Alex-herzong/bb8-3d-printing/bb8教程附件（非拓展板）/问题请扫二维码加我.jpg

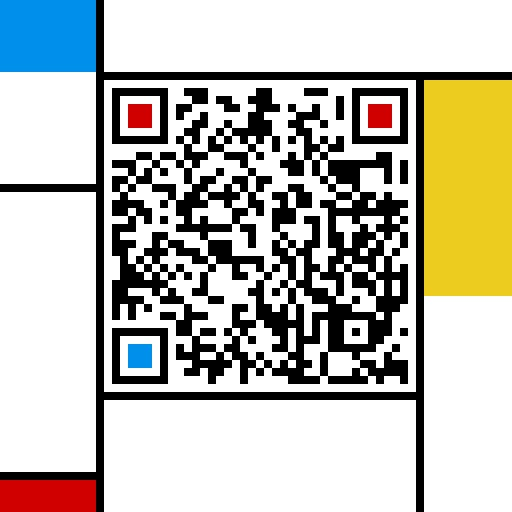
bb8教程附件（非拓展板）/问题请扫二维码加我.jpg
