Alex-herzong/bb8-3d-printing/bb8教程附件（非拓展板）/bb-8机器人制作配件清单.docx

名称 | 链接
250mm、5mm透明亚克力球各一个 | https://detail.tmall.com/item.htm?id=527342035429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 (https://detail.tmall.com/item.htm?id=527342035429&ad_id=&am_id=&cm_id=140105335569ed55e27b&pm_id=&abbucket=16) https://item.taobao.com/item.htm?spm=a1z0d.6639537.1997196601.16.N8McYl&id=41409008235
黄色、银色、黑色、白色喷漆各一瓶 | https://detail.tmall.com/item.htm?id=40748334225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
美纹纸一卷、收音机天线两个 | https://item.taobao.com/item.htm?spm=a230r.1.14.23.nArhsa&id=37469330110&ns=1&abbucket=16#detail
迷你塑料万向球6个、金属万向球2个 | https://item.taobao.com/item.htm?id=41189327831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 https://item.taobao.com/item.htm?spm=a230r.1.14.47.n4MZAc&id=37784466479&ns=1&abbucket=16#detail
20*10圆形强磁2个、20*5圆形强磁2个 | https://shop73172975.taobao.com/category-1174170889.htm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
M3螺栓螺母若干
普通小车马达加轮子2个 | https://detail.tmall.com/item.htm?id=42875687265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
蓝牙模块1个 | https://item.taobao.com/item.htm?spm=a1z09.2.0.0.IatADj&id=520697268815&_u=5did47a13e1
Arduino单片机1个 | https://item.taobao.com/item.htm?spm=a1z09.2.0.0.IatADj&id=44948626552&_u=5did47a69f5
12v锂电池（包括充电器） | https://item.taobao.com/item.htm?spm=a1z09.2.0.0.IatADj&id=524996959929&_u=5did47ab021
稳压模块5v1个 | https://item.taobao.com/item.htm?spm=a1z09.2.0.0.IatADj&id=37939593298&_u=5did47a3a1b
L298n电机驱动1个 | https://detail.tmall.com/item.htm?id=18566053714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 (https://detail.tmall.com/item.htm?id=18566053714&cm_id=140105335569ed55e27b&abbucket=16)
自锁开关1个 | https://item.taobao.com/item.htm?spm=a1z09.2.0.0.IatADj&id=520850580871&_u=5did47a573d
RDS3115舵机1个 | https://item.taobao.com/item.htm?spm=a230r.1.14.4.23b55e6e2gYSWj&id=521728033704&ns=1&abbucket=12#detail
配种物料(自行处理) | 两根直径为25到30mm，长度为100mm的圆柱实心钢材
杜邦线若干 | https://detail.tmall.com/item.htm?id=21555044507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 针孔，针针，孔孔都买些
砂纸若干 | 自己找
打印件 联系微信1451520838打印 | 包括头部、底板、顶部支撑
塑料扎带 | 长扎带若干
透明胶 | 用于粘紧外壳

工具 | 剪刀，刻刀，十字螺丝刀，钳子，热熔胶枪，油性笔，铅笔，圆规等比用工具
