Alex-herzong/bb8-3d-printing/bb8教程附件（非拓展板）/bb-8sw模型/自动恢复 BB-8.SLDASM

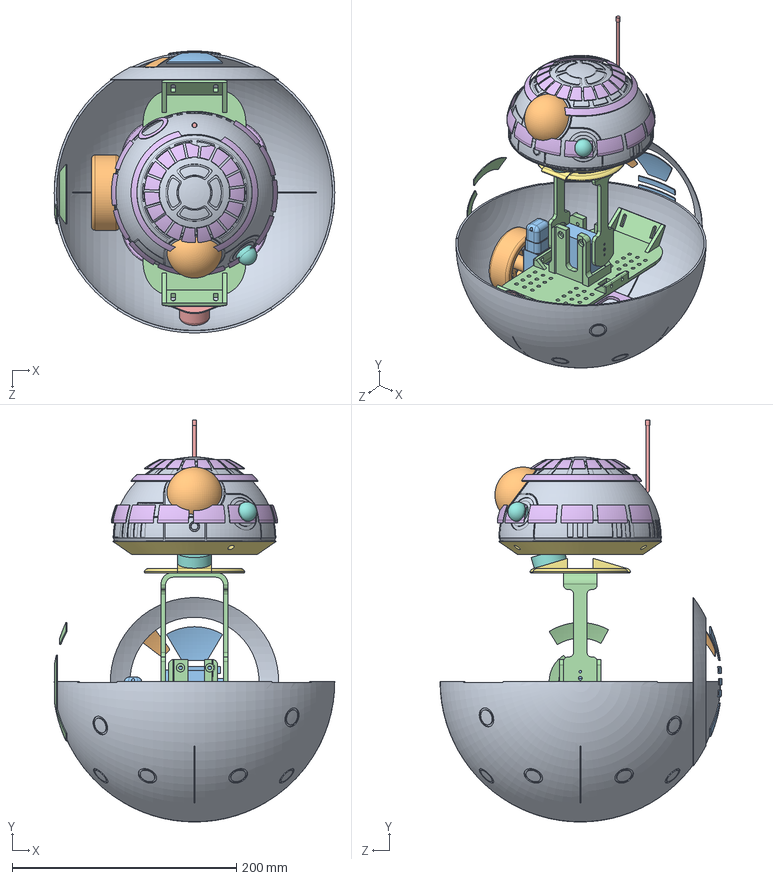
[picture p42: CAD file, 2020-06-07]
bb8教程附件（非拓展板）/bb-8sw模型/自动恢复 BB-8.SLDASM
250.0 x 358.2 x 251.2 mm
底板1
底板2
支撑盘
头部转盘
datou
SR403P舵机
摇臂
