Alex-herzong/bb8-3d-printing/bb8教程附件（非拓展板）/bb-8sw模型/BB-8.SLDASM

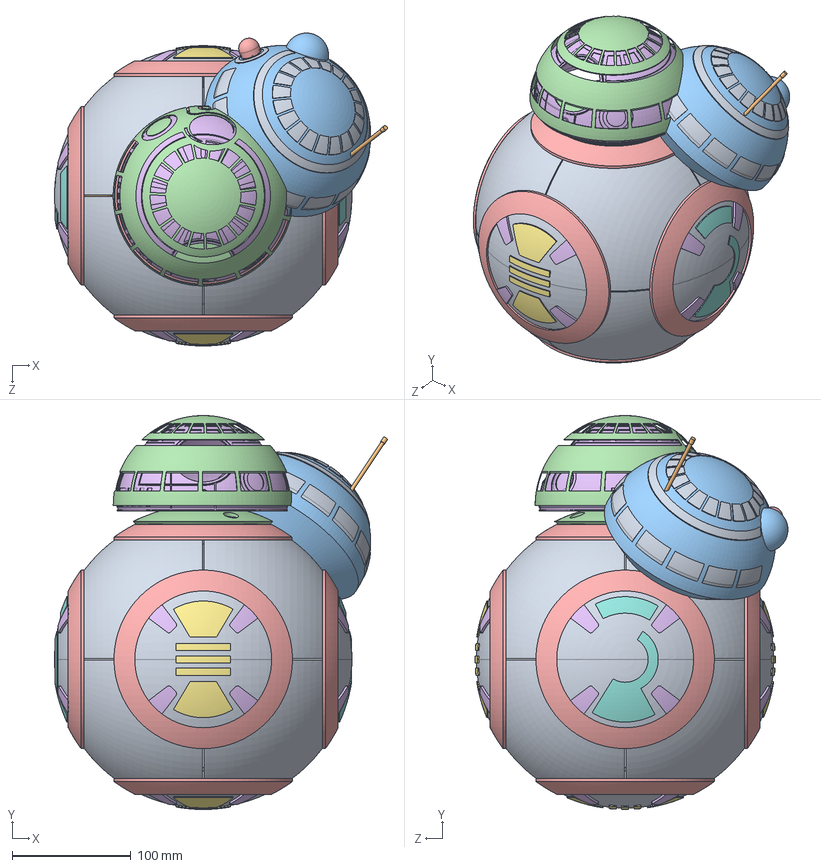
[picture p43: CAD file, 2020-06-07]
bb8教程附件（非拓展板）/bb-8sw模型/BB-8.SLDASM
279.9 x 331.1 x 263.0 mm
外壳1 x 2
车轮 x 2
减速电机2 x 2
零件2
辉盛995舵机
角球 x 2
零件4
舵盘
脖子
支撑盘
磁铁 x 2
waike1^BB-8 x 6
waike2 x 24
waike3 x 4
waike4 x 2
toubudayin
