Alex-herzong/bb8-3d-printing/bb8教程附件（非拓展板）/bb-8sw模型/waike6.sldprt

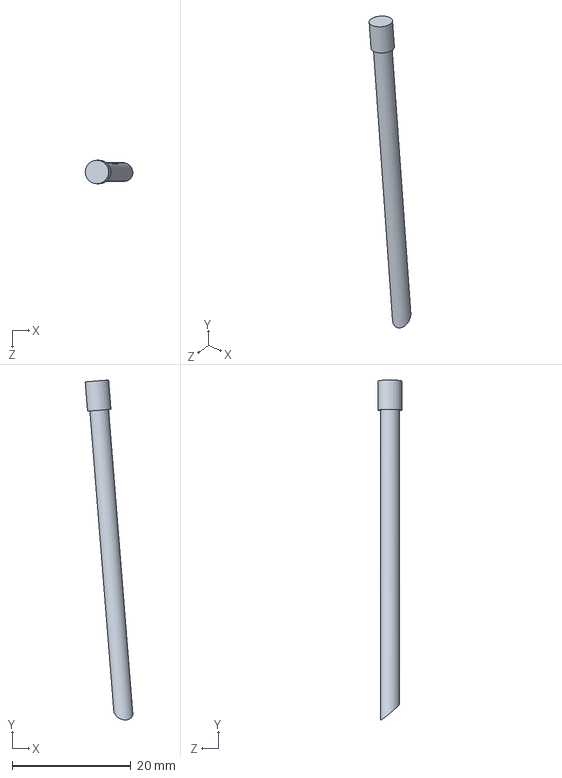
[picture p44: CAD file, 2020-06-07]
bb8教程附件（非拓展板）/bb-8sw模型/waike6.sldprt
8.04 x 57.3 x 3.97 mm
