Alex-herzong/bb8-3d-printing/bb8教程附件（非拓展板）/bb-8sw模型/底板2.sldprt

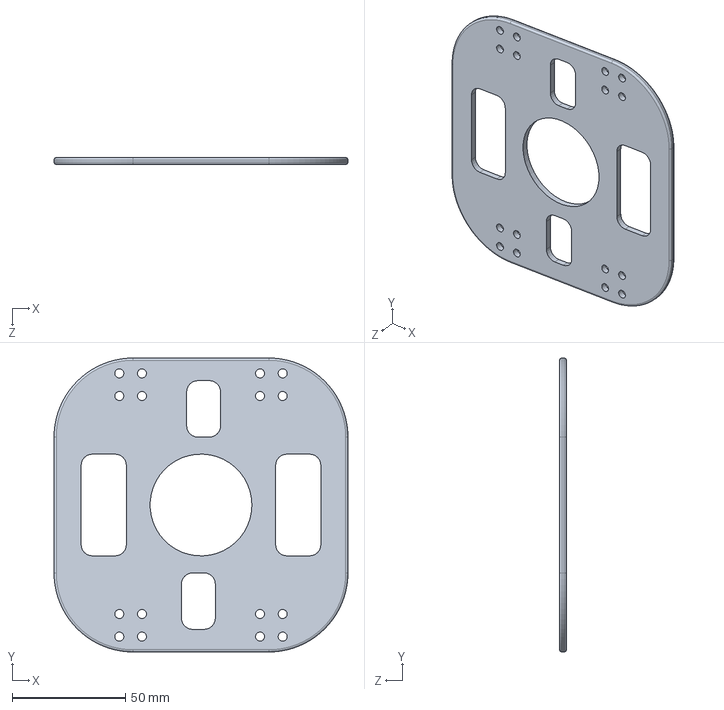
[picture p45: CAD file, 2020-06-07]
bb8教程附件（非拓展板）/bb-8sw模型/底板2.sldprt
130.0 x 130.0 x 3.00 mm
