Alex-herzong/bb8-3d-printing/bb8教程附件（非拓展板）/bb-8sw模型/底板1.sldprt

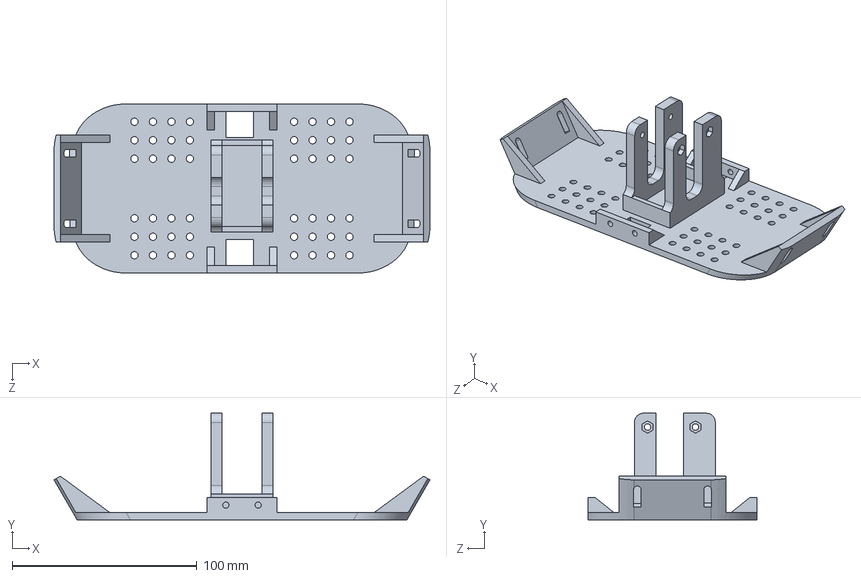
[picture p46: CAD file, 2020-06-07]
bb8教程附件（非拓展板）/bb-8sw模型/底板1.sldprt
203.5 x 57.8 x 91.5 mm
