Alex-herzong/bb8-3d-printing/bb8教程附件（非拓展板）/bb-8sw模型/角球.SLDPRT

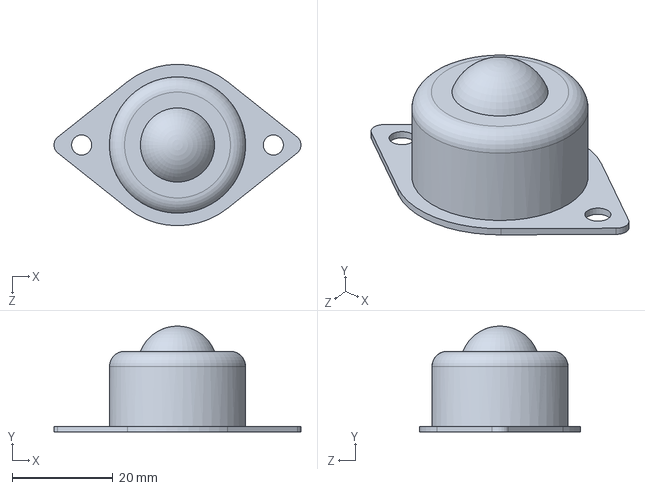
[picture p47: CAD file, 2020-06-07]
bb8教程附件（非拓展板）/bb-8sw模型/角球.SLDPRT
49.0 x 21.0 x 32.0 mm
