Alex-herzong/bb8-3d-printing/bb8教程附件（非拓展板）/bb-8sw模型/头部.sldprt

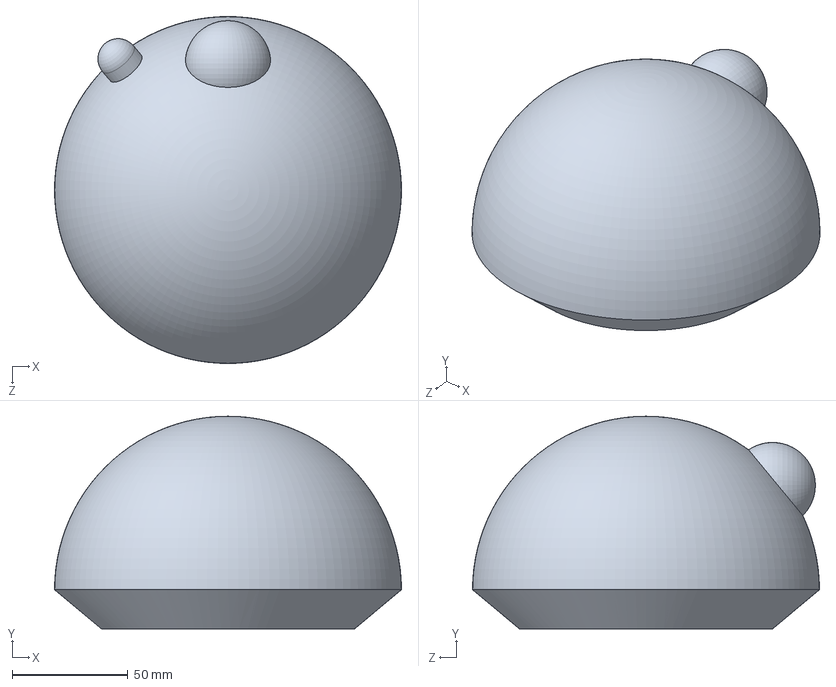
[picture p48: CAD file, 2020-06-07]
bb8教程附件（非拓展板）/bb-8sw模型/头部.sldprt
150.0 x 91.9 x 150.0 mm
