Alex-herzong/bb8-3d-printing/bb8教程附件（非拓展板）/bb-8sw模型/车轮.SLDPRT

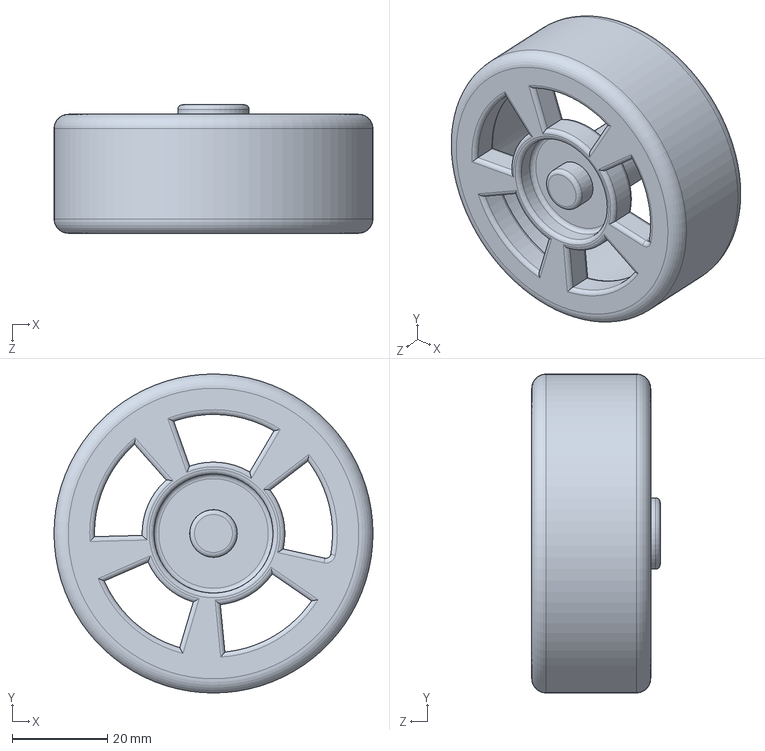
[picture p49: CAD file, 2020-06-07]
bb8教程附件（非拓展板）/bb-8sw模型/车轮.SLDPRT
67.0 x 67.0 x 27.0 mm
