Alex-herzong/bb8-3d-printing/bb8教程附件（非拓展板）/bb-8sw模型/支撑盘.sldprt

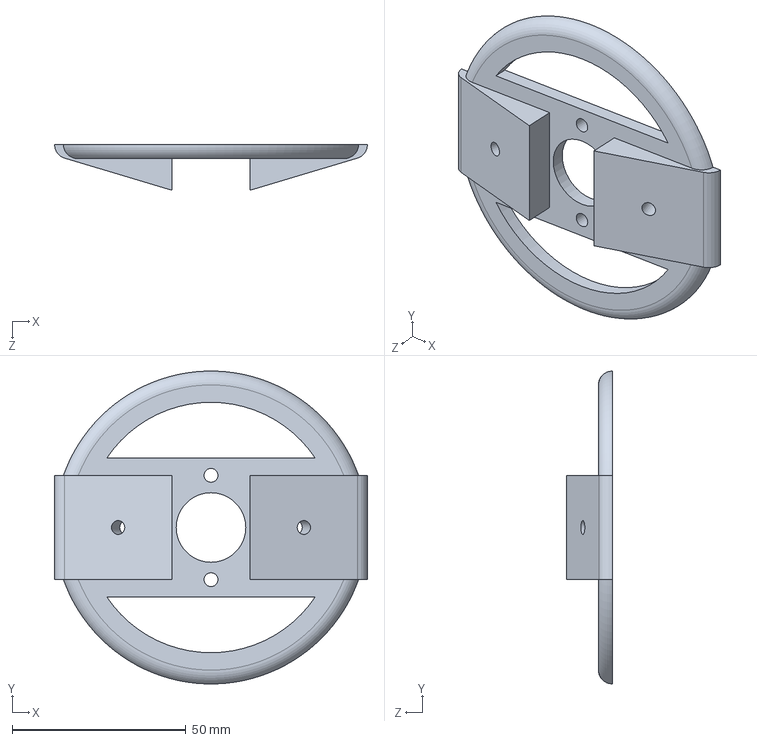
[picture p50: CAD file, 2020-06-07]
bb8教程附件（非拓展板）/bb-8sw模型/支撑盘.sldprt
90.0 x 90.0 x 13.1 mm
