Alex-herzong/bb8-3d-printing/bb8教程附件（非拓展板）/bb-8sw模型/waike1.sldprt

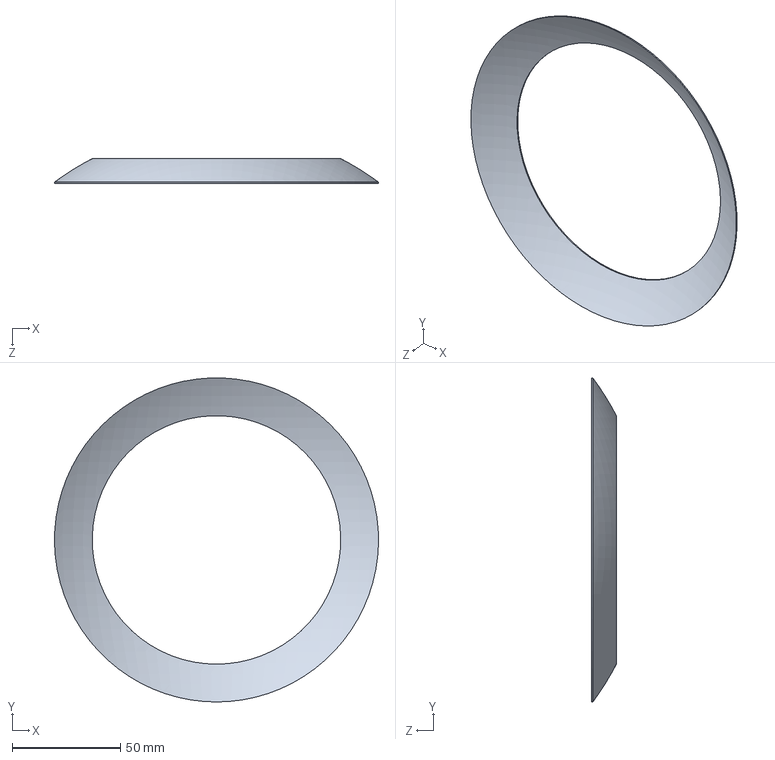
[picture p51: CAD file, 2020-06-07]
bb8教程附件（非拓展板）/bb-8sw模型/waike1.sldprt
150.0 x 149.9 x 11.5 mm
