Alex-herzong/bb8-3d-printing/bb8教程附件（非拓展板）/bb-8sw模型/waike2.sldprt

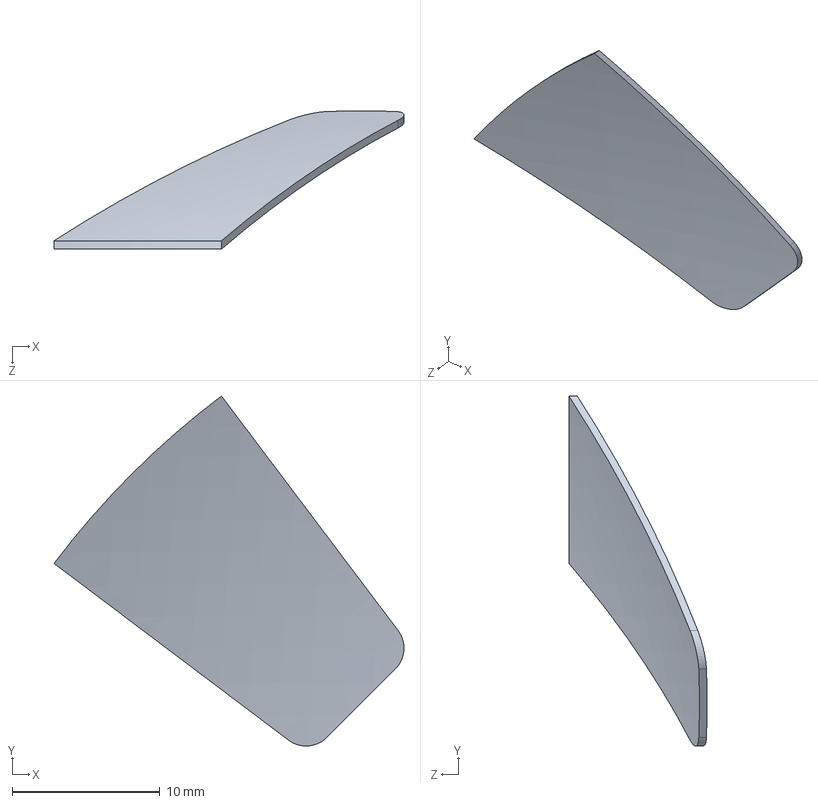
[picture p52: CAD file, 2020-06-07]
bb8教程附件（非拓展板）/bb-8sw模型/waike2.sldprt
23.7 x 23.7 x 9.34 mm
