Alex-herzong/bb8-3d-printing/bb8教程附件（非拓展板）/bb-8sw模型/减速电机2.SLDPRT

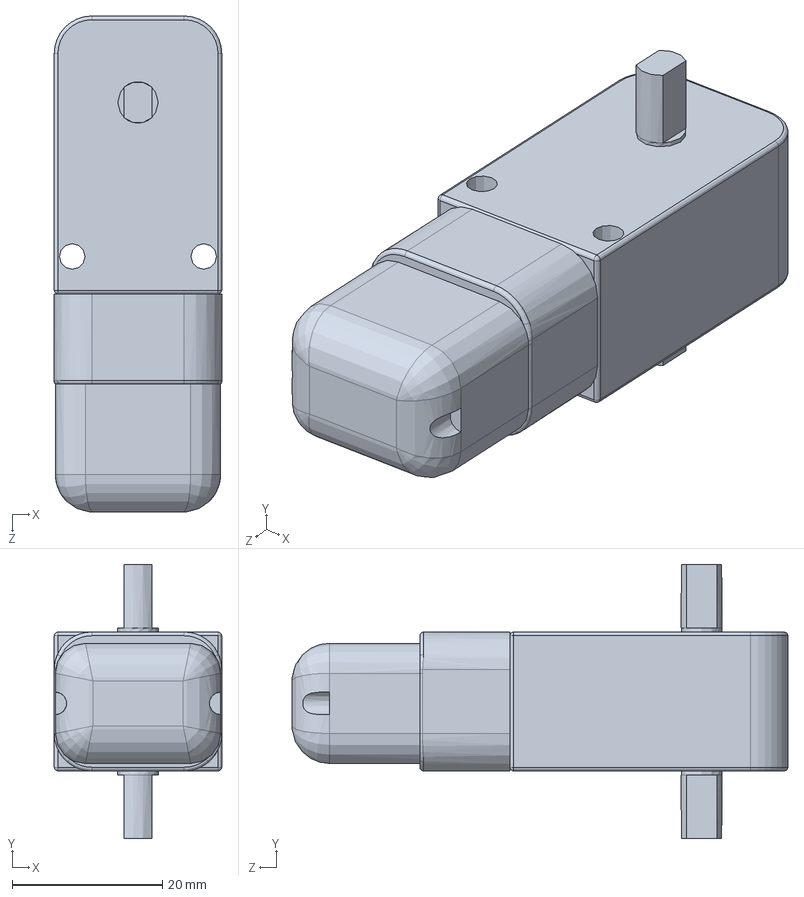
[picture p53: CAD file, 2020-06-07]
bb8教程附件（非拓展板）/bb-8sw模型/减速电机2.SLDPRT
22.3 x 36.5 x 66.0 mm
