Alex-herzong/bb8-3d-printing/bb8教程附件（非拓展板）/bb-8sw模型/磁铁.SLDPRT

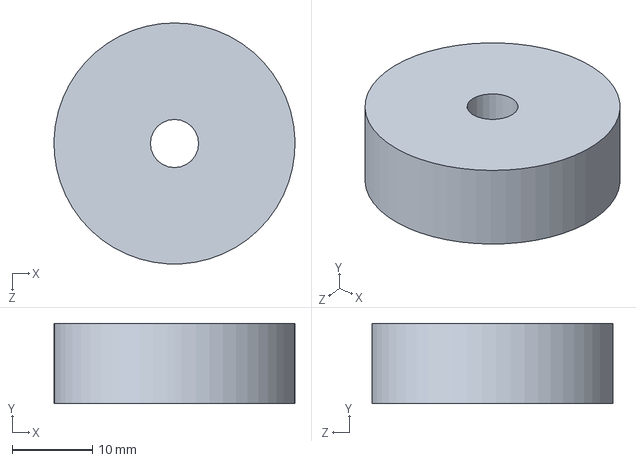
[picture p54: CAD file, 2020-06-07]
bb8教程附件（非拓展板）/bb-8sw模型/磁铁.SLDPRT
30.0 x 10.0 x 30.0 mm
