Alex-herzong/bb8-3d-printing/bb8教程附件（非拓展板）/bb-8sw模型/摇臂.sldprt

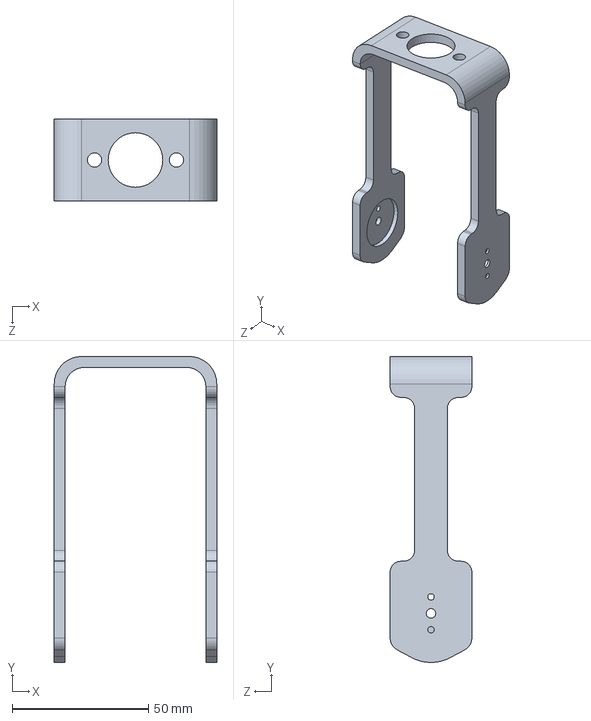
[picture p55: CAD file, 2020-06-07]
bb8教程附件（非拓展板）/bb-8sw模型/摇臂.sldprt
59.5 x 112.1 x 30.0 mm
