Alex-herzong/bb8-3d-printing/bb8教程附件（非拓展板）/bb-8sw模型/SR403P舵机.SLDPRT

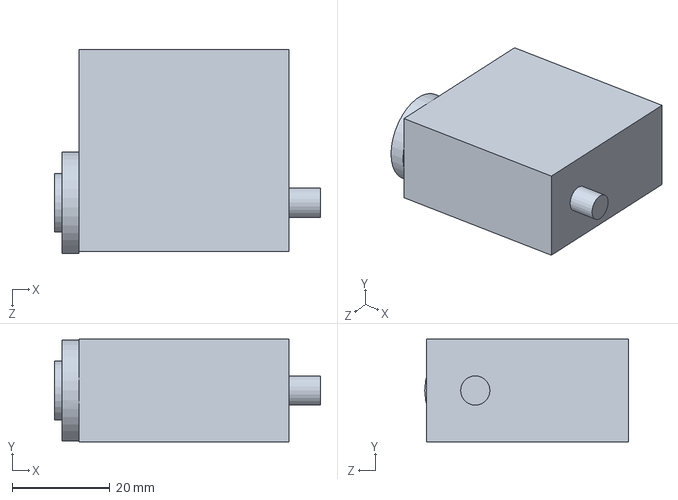
[picture p56: CAD file, 2020-06-07]
bb8教程附件（非拓展板）/bb-8sw模型/SR403P舵机.SLDPRT
54.4 x 21.0 x 41.7 mm
