Alex-herzong/bb8-3d-printing/bb8教程附件（非拓展板）/bb-8sw模型/眼睛.SLDPRT

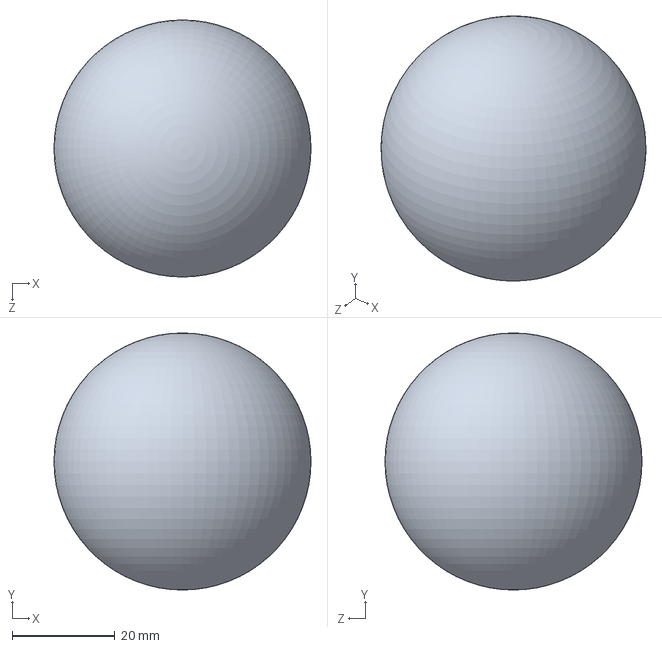
[picture p57: CAD file, 2020-06-07]
bb8教程附件（非拓展板）/bb-8sw模型/眼睛.SLDPRT
50.0 x 50.0 x 50.0 mm
