Alex-herzong/bb8-3d-printing/bb8教程附件（非拓展板）/bb-8sw模型/14.5cm新转盘.sldprt

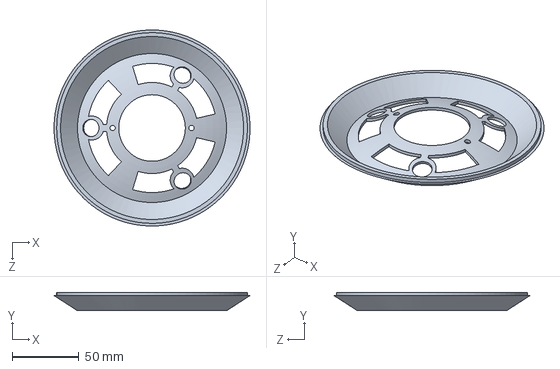
[picture p58: CAD file, 2020-06-07]
bb8教程附件（非拓展板）/bb-8sw模型/14.5cm新转盘.sldprt
147.3 x 13.9 x 147.4 mm
