Alex-herzong/bb8-3d-printing/bb8教程附件（非拓展板）/bb-8sw模型/外壳1.sldprt

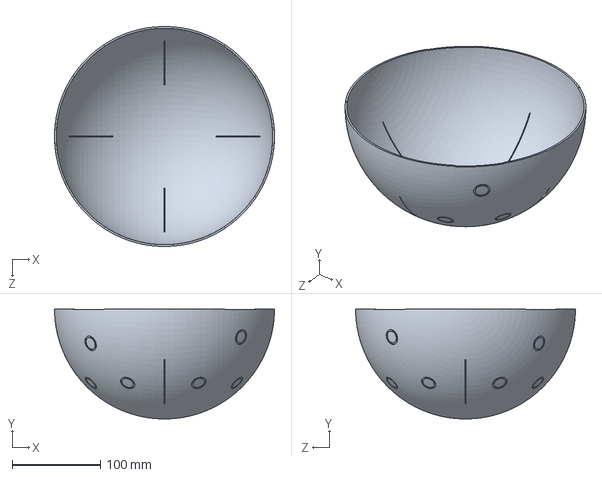
[picture p59: CAD file, 2020-06-07]
bb8教程附件（非拓展板）/bb-8sw模型/外壳1.sldprt
250.0 x 124.9 x 249.9 mm
