Alex-herzong/bb8-3d-printing/bb8教程附件（非拓展板）/bb-8sw模型/datou.SLDPRT

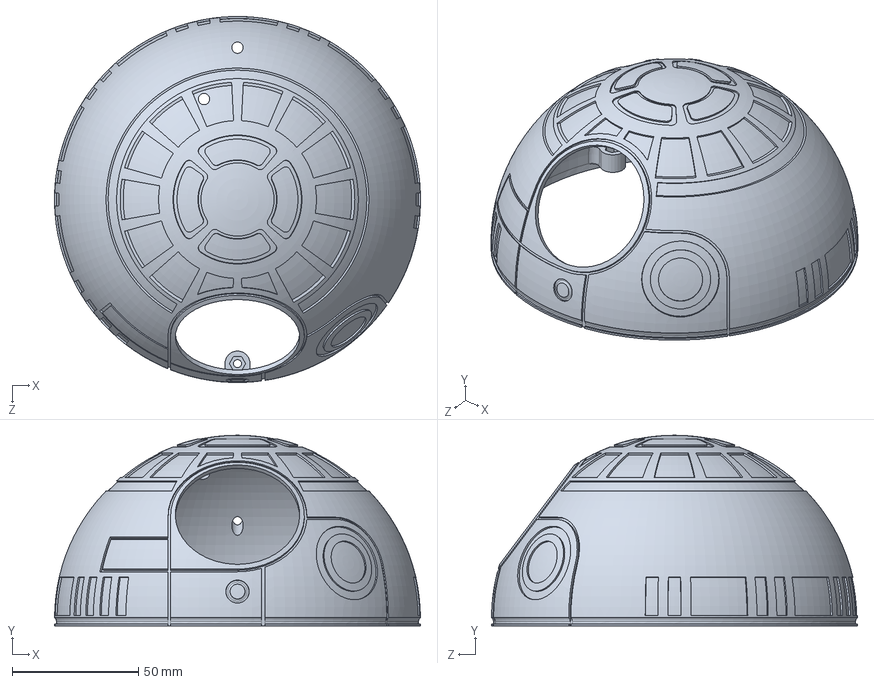
[picture p60: CAD file, 2020-06-07]
bb8教程附件（非拓展板）/bb-8sw模型/datou.SLDPRT
145.0 x 75.5 x 145.0 mm
