Alex-herzong/bb8-3d-printing/bb8教程附件（非拓展板）/bb-8sw模型/舵盘.SLDPRT

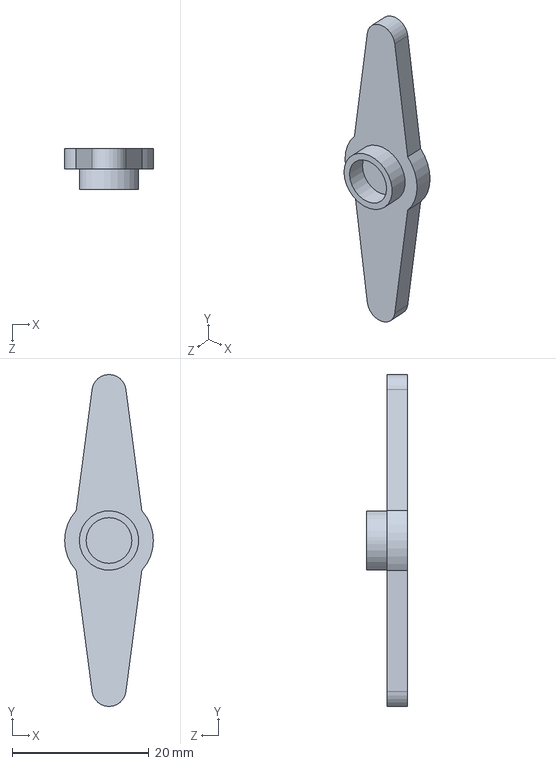
[picture p61: CAD file, 2020-06-07]
bb8教程附件（非拓展板）/bb-8sw模型/舵盘.SLDPRT
13.0 x 48.6 x 6.00 mm
