Alex-herzong/bb8-3d-printing/bb8教程附件（非拓展板）/bb-8sw模型/头部转盘.sldprt

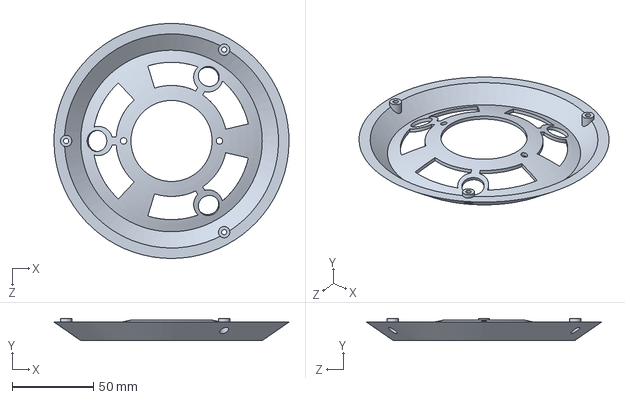
[picture p62: CAD file, 2020-06-07]
bb8教程附件（非拓展板）/bb-8sw模型/头部转盘.sldprt
145.0 x 13.6 x 144.9 mm
