Alex-herzong/bb8-3d-printing/(list of files, cad)

Other CAD files:
bb8教程附件（非拓展板）/bb-8sw模型/m3螺柱.sldprt
bb8教程附件（非拓展板）/bb-8sw模型/waike4.sldprt
bb8教程附件（非拓展板）/bb-8sw模型/waike5.sldprt
bb8教程附件（非拓展板）/bb-8sw模型/waike3.sldprt
