Alex-herzong/bb8-3d-printing/bb8教程附件（非拓展板）/bb8电路图 .pdf

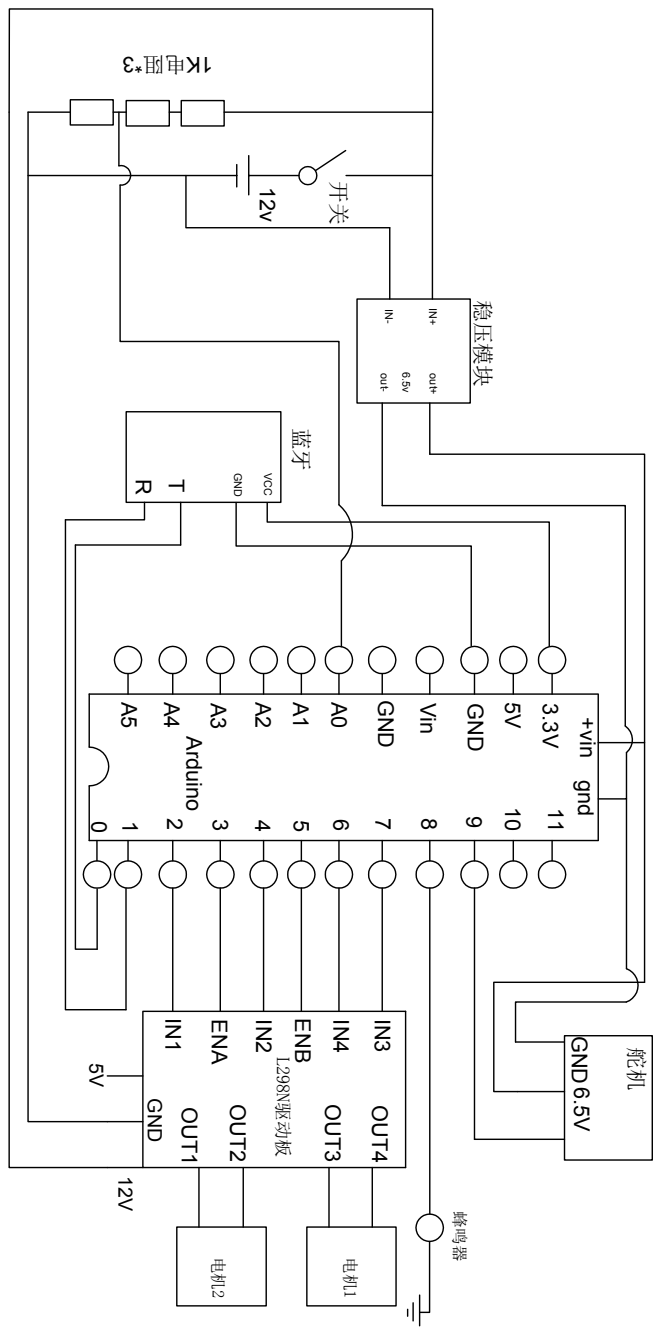
[picture p63: page 1]
GND; Vin; Arduino; OUT1; OUT2; 驱动板; OUT3; OUT4; ENA; ENB; +vin gnd; VCC; 6.5V GND; out-; out+; 蜂鸣器
